pklopping/heimdall/hardware/outside_boards/Reference/readme.md

# Reference Docs

## Antenna Design

The [NXP Antenna Tool](https://community.nxp.com/t5/NFC/bd-p/nfc) was used to
identify the component values and antenna circuit design.
