pklopping/heimdall/hardware/shared/cots/VLS6045EX-3R3N.stp

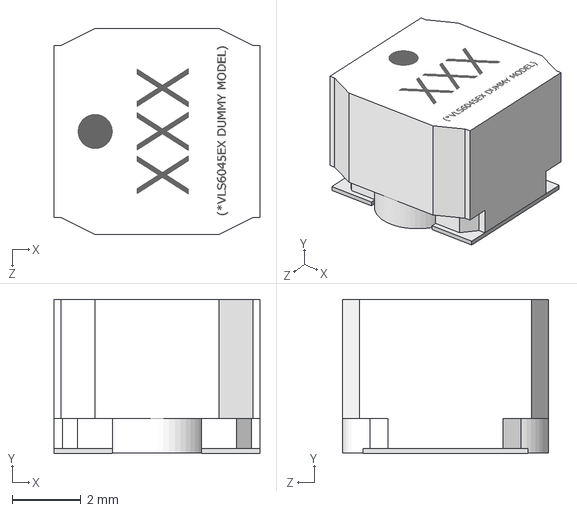
[picture p1: CAD file, 2026-01-07]
hardware/shared/cots/VLS6045EX-3R3N.stp
6.00 x 4.50 x 6.00 mm
VLS6045EX_C(3Dmodel)
VLS6045EX_T(3Dmodel)
