pklopping/heimdall/hardware/shared/cots/5-2337993-2.stp

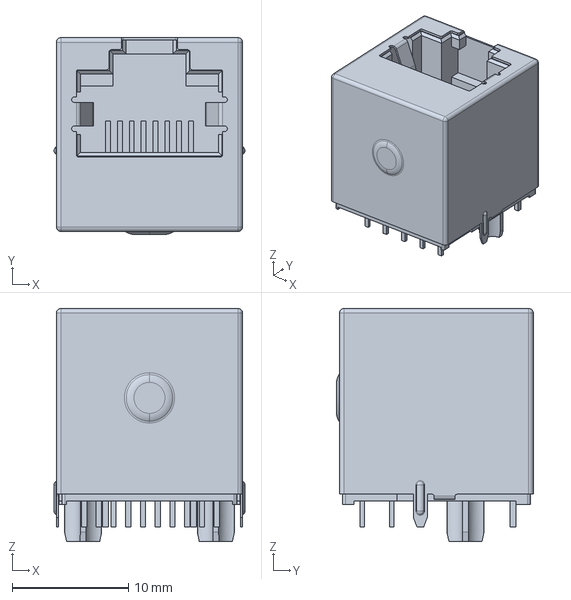
[picture p2: CAD file, 2025-12-01]
hardware/shared/cots/5-2337993-2.stp
16.4 x 16.9 x 20.1 mm
