pklopping/heimdall/hardware/shared/cots/10118193-0001lfc.stp

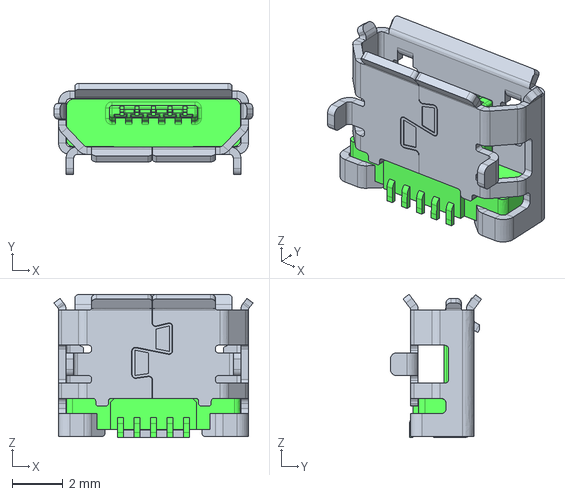
[picture p3: CAD file, 2025-12-01]
hardware/shared/cots/10118193-0001lfc.stp
7.86 x 3.60 x 5.66 mm
