pklopping/heimdall/hardware/shared/cots/CMT-1075-SMT-TR.stp

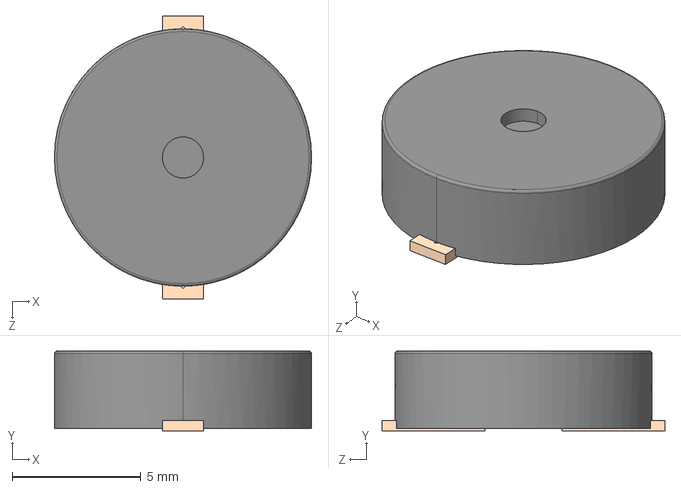
[picture p4: CAD file, 2025-09-20]
hardware/shared/cots/CMT-1075-SMT-TR.stp
10.0 x 3.10 x 11.0 mm
