pklopping/heimdall/hardware/shared/cots/43045-1019.stp

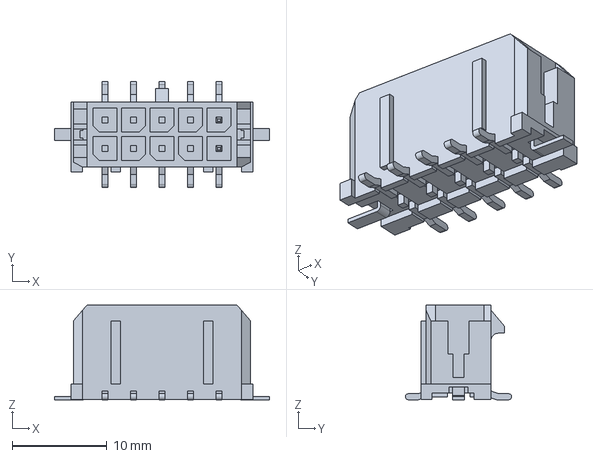
[picture p5: CAD file, 2025-09-20]
hardware/shared/cots/43045-1019.stp
22.6 x 11.2 x 9.96 mm
