pklopping/heimdall/hardware/shared/cots/CLRC66303HNY.stp

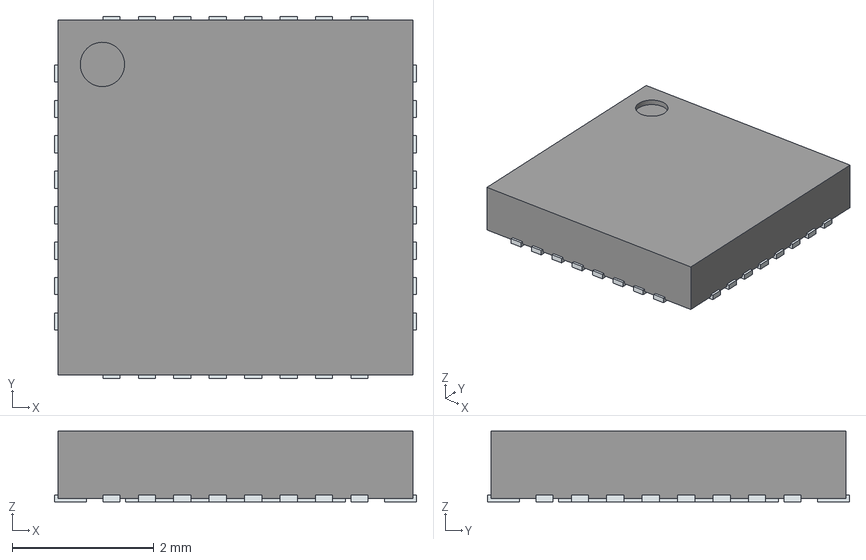
[picture p6: CAD file, 2025-09-20]
hardware/shared/cots/CLRC66303HNY.stp
5.10 x 5.10 x 1.00 mm
ThermalPin
PinsArrayLR
PinsArrayTB
