pklopping/heimdall/hardware/shared/cots/53398-1071.stp

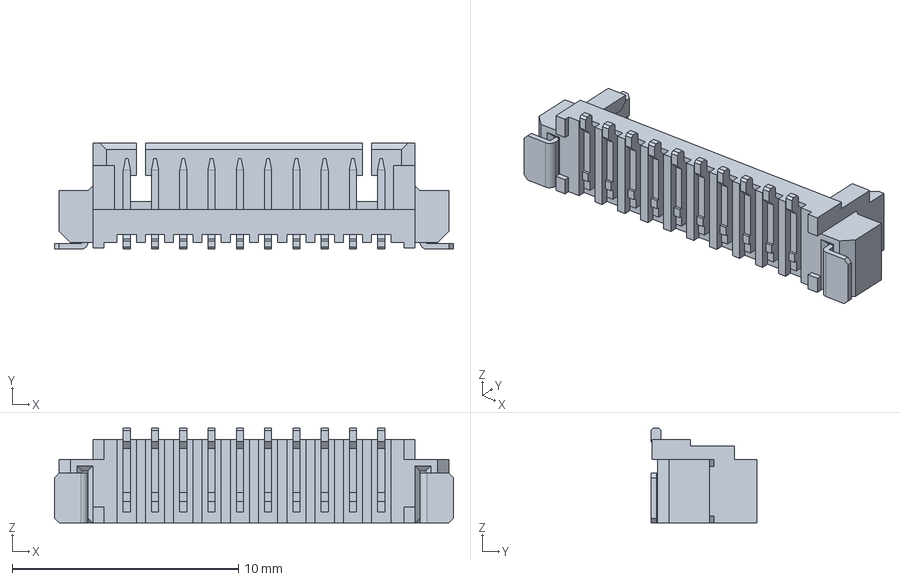
[picture p7: CAD file, 2025-09-20]
hardware/shared/cots/53398-1071.stp
17.6 x 4.70 x 4.20 mm
