pklopping/heimdall/hardware/buzzer_test/buzzer_test.kicad_pcb

## KiCad design hardware/buzzer_test/buzzer_test.kicad_pcb (2026-04-17)

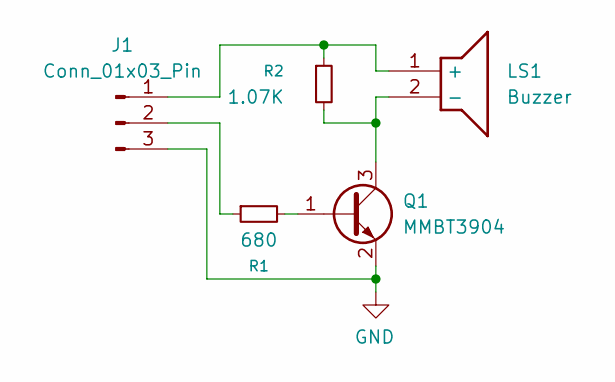
[picture p8: schematic buzzer_test.kicad_sch]

Parts:
J1: Conn_01x03_Pin; PinHeader_1x03_P2.54mm_Vertical
LS1: Buzzer; CMT1075SMTTR; Mouser Part Number 490-CMT-1075-SMT-TR
Q1: MMBT3904; SOT-23
R1: 680; R_0805_2012Metric
R2: 1.07K; R_0805_2012Metric

Connections:
GND: J1.3, Q1.2 (E)
unnamed: J1.1, LS1.1 (+), R2.1
unnamed: J1.2, R1.1
unnamed: LS1.2 (-), Q1.3 (C), R2.2
unnamed: Q1.1 (B), R1.2

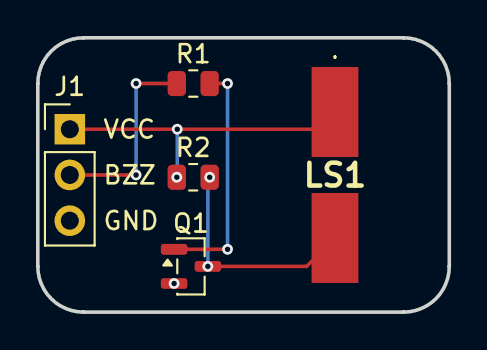
[picture p9: board buzzer_test.kicad_pcb from above]

Board: 2 copper layers, 22.9 x 15.2 mm, 5 parts (0 on the bottom side), 5 nets.
