pklopping/heimdall/hardware/inside_board/heimdall_insideboard.kicad_pcb

## KiCad design hardware/inside_board/heimdall_insideboard.kicad_pcb (2026-04-14)

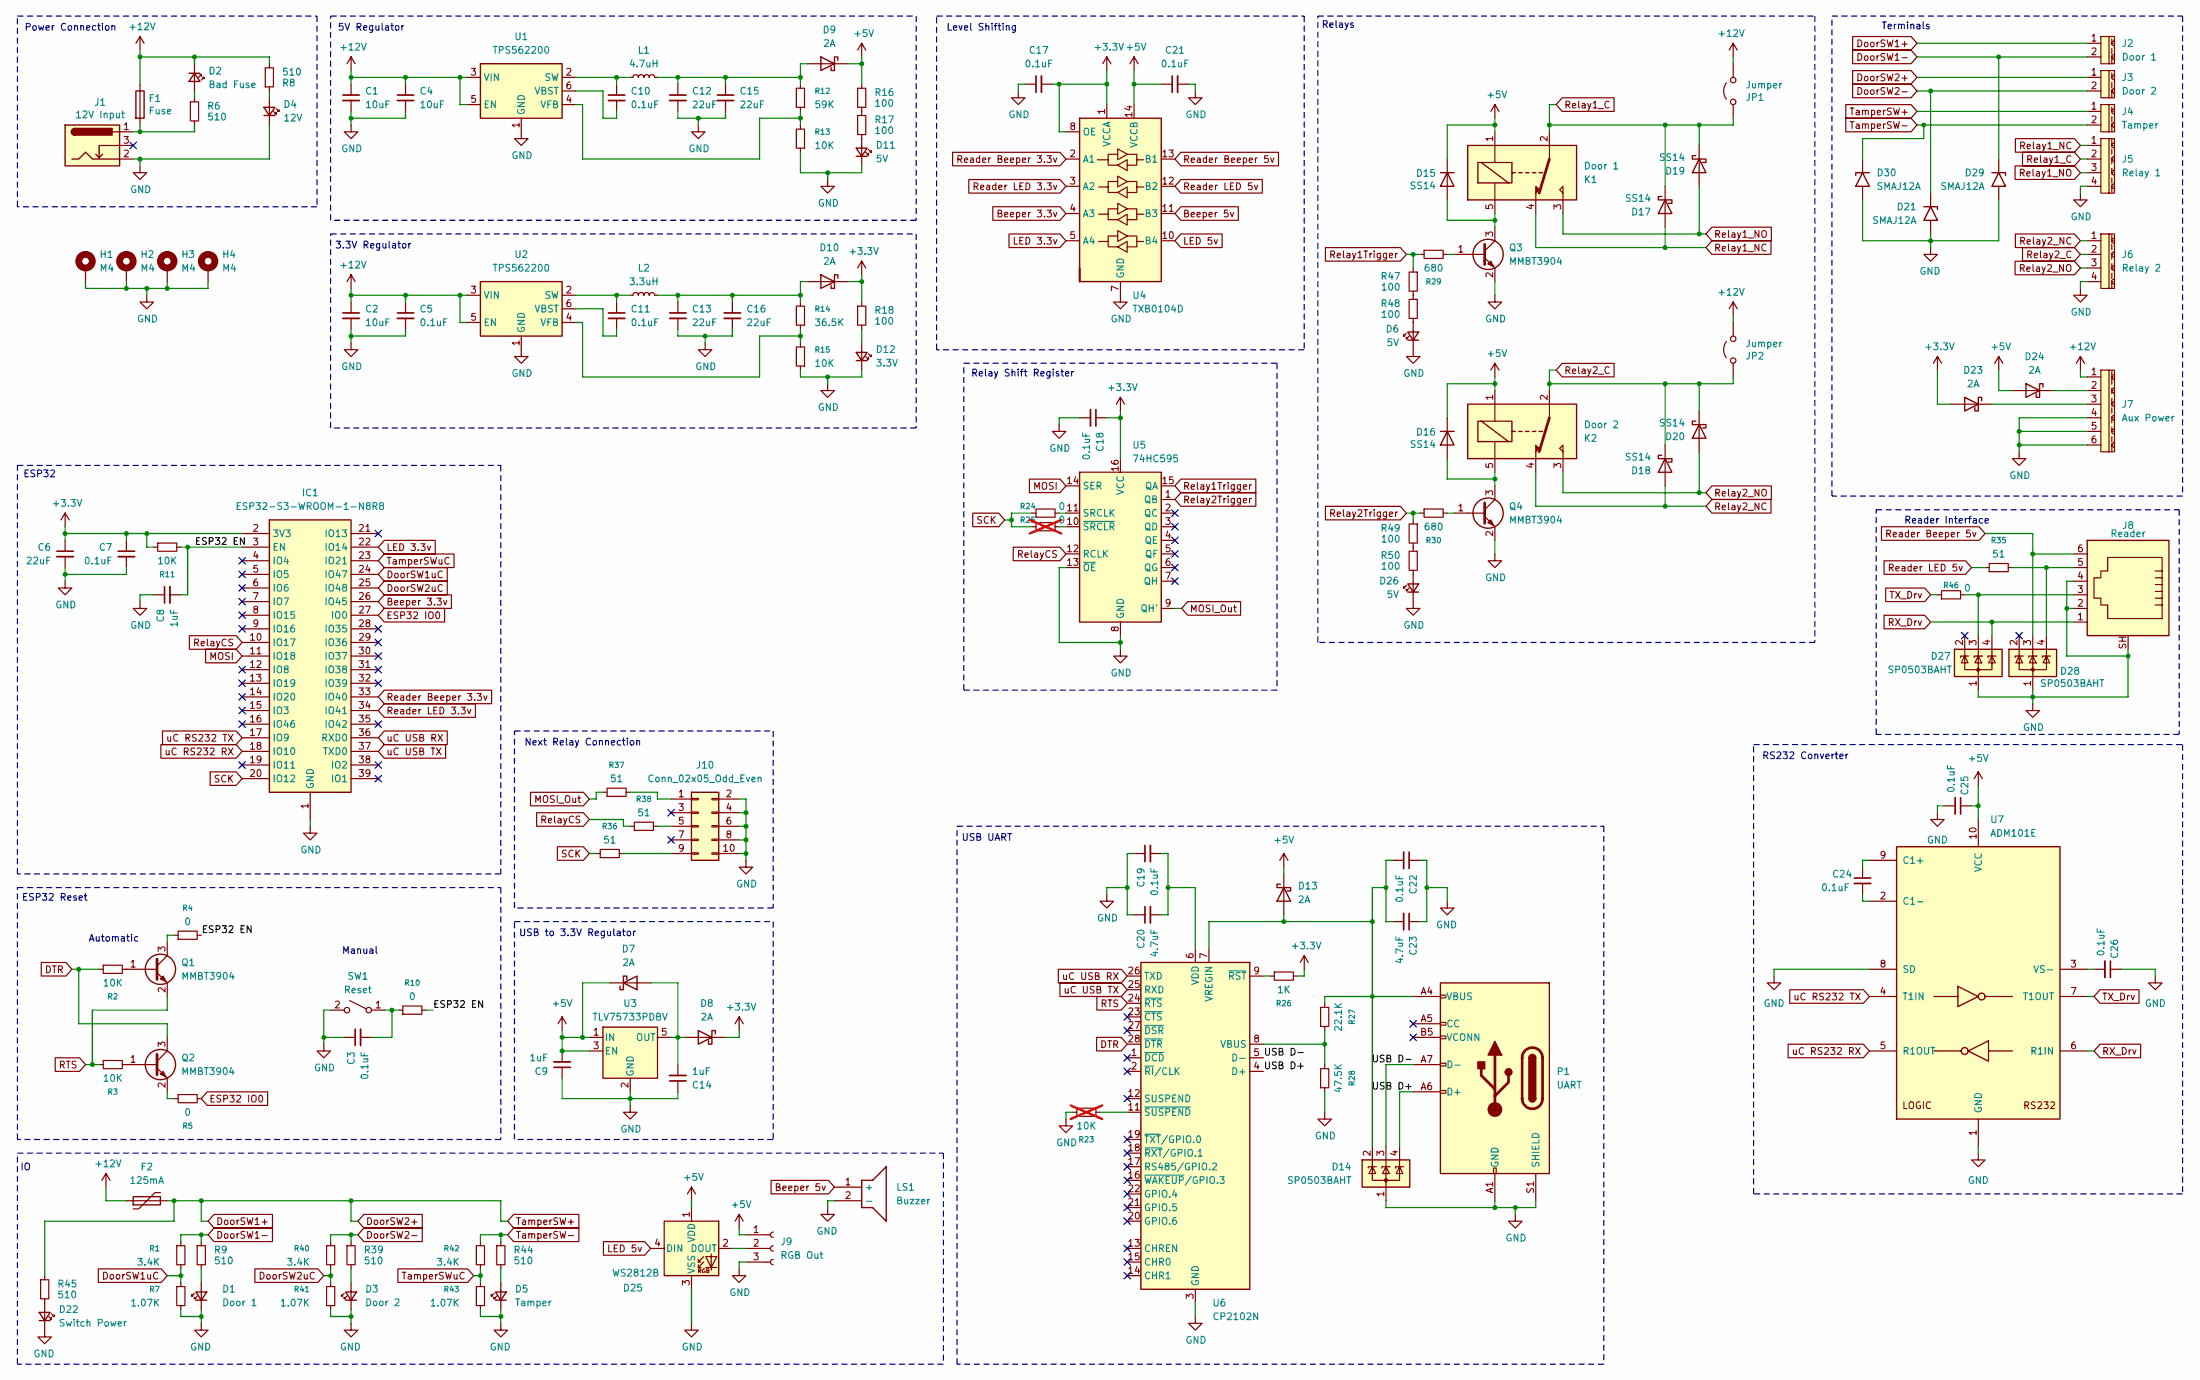
[picture p10: schematic heimdall_insideboard.kicad_sch, Heimdall Relay Board]

Parts:
C1, C2, C4: 10uF; C_0805_2012Metric
C3, C5, C7, C10, C11, C17, C18, C19, C21, C22, C24, C25, C26: 0.1uF; C_0805_2012Metric
C6, C12, C13, C15, C16: 22uF; C_0805_2012Metric
C8, C9, C14: 1uF; C_0805_2012Metric
C20, C23: 4.7uF; C_0805_2012Metric
D1: Door 1; LED_0805_2012Metric
D2: Bad Fuse; LED_0805_2012Metric
D3: Door 2; LED_0805_2012Metric
D4: 12V; LED_0805_2012Metric
D5: Tamper; LED_0805_2012Metric
D6, D11, D26: 5V; LED_0805_2012Metric
D7, D8, D9, D10, D13, D23, D24: 2A; D_SMB
D12: 3.3V; LED_0805_2012Metric
D14, D27, D28: SP0503BAHT; SOT-143
D15, D16, D17, D18, D19, D20: SS14; D_SMA
D21, D29, D30: SMAJ12A; D_SMA
D22: Switch Power; LED_0805_2012Metric
D25: WS2812B; LED_WS2812B_PLCC4_5.0x5.0mm_P3.2mm
F1: Fuse; Fuseholder_Clip-5x20mm_Littelfuse_521_Lateral_P17.00x5.00mm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
F2: 125mA; Fuse_1206_3216Metric
H1, H2, H3, H4: M4; MountingHole_4.3mm_M4_Pad_Via
IC1: ESP32-S3-WROOM-1-N8R8; ESP32S3WROOM1N8R8; Mouser Part Number 356-EP32S3WROOM1N8R8
J1: 12V Input; BarrelJack_Wuerth_6941xx301002
J2: Door 1; 1759017
J3: Door 2; 1759017
J4: Tamper; 1759017
J5: Relay 1; 1759033
J6: Relay 2; 1759033
J7: Aux Power; 1759059
J8: Reader; CRJ0241TH
J9: RGB Out; PinHeader_1x03_P2.54mm_Vertical
J10: Conn_02x05_Odd_Even; 75869-101LF
JP1, JP2: Jumper; PinHeader_1x03_P2.54mm_Vertical
K1: Door 1; G6RN17EASICFHADC5; Manufacturer_Part_Number G6RN-17-E-ASI-CF-HA DC5
K2: Door 2; G6RN17EASICFHADC5; Manufacturer_Part_Number G6RN-17-E-ASI-CF-HA DC5
L1: 4.7uH; SRR1260A4R7Y
L2: 3.3uH; SRR1260A4R7Y
LS1: Buzzer; CMT1075SMTTR; Mouser Part Number 490-CMT-1075-SMT-TR
P1: UART; USB4920-00-A
Q1, Q2, Q3, Q4: MMBT3904; SOT-23
R1, R40, R42: 3.4K; R_0805_2012Metric
R2, R3, R11, R13, R15: 10K; R_0805_2012Metric
R4, R5, R10, R24, R46: 0; R_0805_2012Metric
R6, R8, R9, R39, R44, R45: 510; R_0805_2012Metric
R7, R41, R43: 1.07K; R_0805_2012Metric
R12: 59K; R_0805_2012Metric
R14: 36.5K; R_0805_2012Metric
R16, R17, R18, R47, R48, R49, R50: 100; R_0805_2012Metric
R23: 10K; R_0805_2012Metric; not fitted
R25: 0; R_0805_2012Metric; not fitted
R26: 1K; R_0805_2012Metric
R27: 22.1K; R_0805_2012Metric
R28: 47.5K; R_0805_2012Metric
R29, R30: 680; R_0805_2012Metric
R35, R36, R37, R38: 51; R_0805_2012Metric
SW1: Reset; SW_SPST_Omron_B3FS-100xP
U1, U2: TPS562200; SOT-23-6
U3: TLV75733PDBV; SOT-23-5
U4: TXB0104D; SOIC-14_3.9x8.7mm_P1.27mm
U5: 74HC595; SOIC-16W_7.5x10.3mm_P1.27mm
U6: CP2102N; QFN-28-1EP_5x5mm_P0.5mm_EP3.35x3.35mm
U7: ADM101E; MSOP-10_3x3mm_P0.5mm

Connections:
+3.3V: C6.1, C7.1, C17.2, C18.1, D8.1 (K), D10.1 (K), D23.2 (A), IC1.2 (3V3), R11.1, R18.1, R26.2, U4.1 (VCCA), U4.8 (OE), U5.16 (VCC)
+5V: C9.2, C21.1, C25.1, D7.1 (K), D9.1 (K), D13.1 (K), D15.1 (K), D16.1 (K), D24.2 (A), D25.1 (VDD), J9.1, K1.1, K2.1, R16.1, U3.1 (IN), U3.3 (EN), U4.14 (VCCB), U7.10 (VCC)
+12V: C1.1, C2.1, C4.1, C5.1, D2.1 (K), F1.1, F2.1, J7.1, JP1.1 (A), JP2.1 (A), R8.2, U1.3 (VIN), U1.5 (EN), U2.3 (VIN), U2.5 (EN)
/ESP32 EN: C8.2, IC1.3 (EN), R4.2, R10.2, R11.2
/USB D+: D14.4 (K), P1.A6 (D+), U6.4 (D+)
/USB D-: D14.3 (K), P1.A7 (D-), U6.5 (D-)
Beeper 3.3v: IC1.26 (IO45), U4.4 (A3)
Beeper 5v: LS1.1 (+), U4.11 (B3)
DTR: Q2.3 (C), R2.1, U6.28 (~DTR)
DoorSW1+: F2.2, J2.1, J3.1, J4.1, R45.1
DoorSW1-: D29.1 (A1), J2.2, R1.1, R9.1
DoorSW1uC: IC1.24 (IO47), R1.2, R7.1
DoorSW2-: D21.1 (A1), J3.2, R39.1, R40.1
DoorSW2uC: IC1.25 (IO48), R40.2, R41.1
ESP32 IO0: IC1.27 (IO0), R5.2
GND: C1.2, C2.2, C3.1, C4.2, C5.2, C6.2, C7.2, C8.1, C9.1, C12.2, C13.2, C14.1, C15.2, C16.2, C17.1, C18.2, C19.1, C20.1, C21.2, C22.1, C23.1, C25.2, C26.1, D1.1 (K), D3.1 (K), D4.1 (K), D5.1 (K), D6.1 (K), D11.1 (K), D12.1 (K), D14.1 (A), D21.2 (A2), D22.1 (K), D25.3 (VSS), D26.1 (K), D27.1 (A), D28.1 (A), D29.2 (A2), D30.2 (A2), H1.1, H2.1, H3.1, H4.1, IC1.1 (GND), J1.2, J5.4, J6.4, J7.4, J7.5, J7.6, J8.2, J8.4, J8.SH, J9.3, J10.2, J10.4, J10.6, J10.8, J10.10, LS1.2 (-), P1.A1 (GND), P1.A12 (GND), P1.B1 (GND), P1.B12 (GND), P1.S1 (SHIELD), Q3.2 (E), Q4.2 (E), R7.2, R13.1, R15.1, R23.1, R28.1, R41.2, R43.2, SW1.2 (B), U1.1 (GND), U2.1 (GND), U3.2 (GND), U4.7 (GND), U5.8 (GND), U5.13 (~OE), U6.3 (GND), U6.29 (GND), U7.1 (GND), U7.8 (SD)
LED 3.3v: IC1.22 (IO14), U4.5 (A4)
LED 5v: D25.4 (DIN), U4.10 (B4)
MOSI: IC1.11 (IO18), U5.14 (SER)
MOSI_Out: R37.1, U5.9 (QH')
unnamed: D1.2 (A), R9.2
unnamed: D2.2 (A), R6.1
unnamed: D3.2 (A), R39.2
unnamed: D4.2 (A), R8.1
unnamed: D5.2 (A), R44.2
unnamed: D6.2 (A), R48.2
unnamed: C14.2, D7.2 (A), D8.2 (A), U3.5 (OUT)
unnamed: C12.1, C15.1, D9.2 (A), L1.2, R12.2
unnamed: C13.1, C16.1, D10.2 (A), L2.2, R14.2
unnamed: D11.2 (A), R17.2
unnamed: D12.2 (A), R18.2
unnamed: C22.2, C23.2, D13.2 (A), D14.2 (K), P1.A4 (VBUS), P1.A9 (VBUS), P1.B4 (VBUS), P1.B9 (VBUS), R27.2, U6.7 (VREGIN)
unnamed: D15.2 (A), K1.5, Q3.3 (C)
unnamed: D16.2 (A), K2.5, Q4.3 (C)
unnamed: D22.2 (A), R45.2
unnamed: D23.1 (K), J7.3
unnamed: D24.1 (K), J7.2
unnamed: D25.2 (DOUT), J9.2
unnamed: D26.2 (A), R50.2
unnamed: D27.3 (K), J8.3, R46.2
unnamed: D28.4 (K), J8.5, R35.2
unnamed: F1.2, J1.1, R6.2
unnamed: J10.1, R37.2
unnamed: J10.5, R38.2
unnamed: J10.9, R36.2
unnamed: Q1.1 (B), R2.2
unnamed: Q1.3 (C), R4.1
unnamed: Q2.1 (B), R3.2
unnamed: Q2.2 (E), R5.1
unnamed: Q3.1 (B), R29.2
unnamed: Q4.1 (B), R30.2
unnamed: R16.2, R17.1
unnamed: R47.2, R48.1
unnamed: R49.2, R50.1
unnamed: C3.2, R10.1, SW1.1 (A)
unnamed: C10.1, L1.1, U1.2 (SW)
unnamed: C10.2, U1.6 (VBST)
unnamed: R12.1, R13.2, U1.4 (VFB)
unnamed: C11.1, L2.1, U2.2 (SW)
unnamed: C11.2, U2.6 (VBST)
unnamed: R14.1, R15.2, U2.4 (VFB)
unnamed: R24.2, U5.11 (SRCLK)
unnamed: R25.2, U5.10 (~SRCLR)
unnamed: R27.1, R28.2, U6.8 (VBUS)
unnamed: C19.2, C20.2, U6.6 (VDD)
unnamed: R26.1, U6.9 (~RST)
unnamed: R23.2, U6.11 (~SUSPEND)
unnamed: C24.1, U7.9 (C1+)
unnamed: C24.2, U7.2 (C1-)
unnamed: C26.2, U7.3 (VS-)
RTS: Q1.2 (E), R3.1, U6.24 (~RTS)
RX_Drv: D27.4 (K), J8.1, U7.6 (R1IN)
Reader Beeper 3.3v: IC1.33 (IO40), U4.2 (A1)
Reader Beeper 5v: D28.3 (K), J8.6, U4.13 (B1)
Reader LED 3.3v: IC1.34 (IO41), U4.3 (A2)
Reader LED 5v: R35.1, U4.12 (B2)
Relay1Trigger: R29.1, R47.1, U5.15 (QA)
Relay1_C: D17.1 (K), D19.1 (K), J5.2, JP1.2 (B), K1.2
Relay1_NC: D17.2 (A), J5.1, K1.4
Relay1_NO: D19.2 (A), J5.3, K1.3
Relay2Trigger: R30.1, R49.1, U5.1 (QB)
Relay2_C: D18.1 (K), D20.1 (K), J6.2, JP2.2 (B), K2.2
Relay2_NC: D18.2 (A), J6.1, K2.4
Relay2_NO: D20.2 (A), J6.3, K2.3
RelayCS: IC1.10 (IO17), R38.1, U5.12 (RCLK)
SCK: IC1.20 (IO12), R24.1, R25.1, R36.1
TX_Drv: R46.1, U7.7 (T1OUT)
TamperSW-: D30.1 (A1), J4.2, R42.1, R44.1
TamperSWuC: IC1.23 (IO21), R42.2, R43.1
uC RS232 RX: IC1.18 (IO10), U7.5 (R1OUT)
uC RS232 TX: IC1.17 (IO9), U7.4 (T1IN)
uC USB RX: IC1.36 (RXD0), U6.26 (TXD)
uC USB TX: IC1.37 (TXD0), U6.25 (RXD)

Notes on the sheet:
Power Connection
Relay Shift Register
Automatic
RS232 Converter
ESP32 Reset
USB to 3.3V Regulator
Terminals
Next Relay Connection
Manual
3.3V Regulator
5V Regulator
Reader Interface
Relays
Level Shifting
USB UART
ESP32

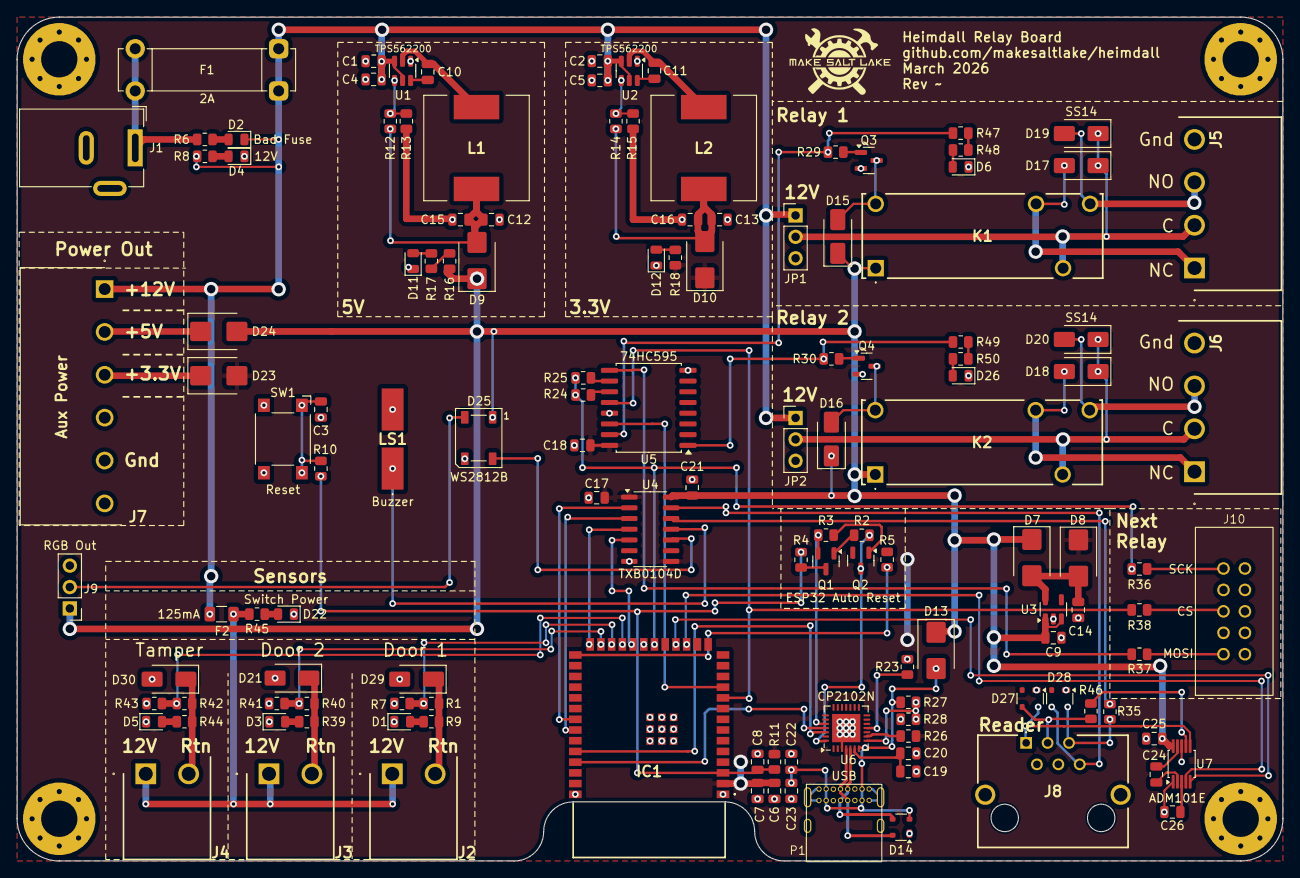
[picture p11: board heimdall_insideboard.kicad_pcb from above]

Board: 2 copper layers, 150.0 x 100.0 mm, 135 parts (0 on the bottom side), 93 nets.
