pklopping/heimdall/hardware/outside_boards/reader/reader.kicad_pcb

## KiCad design hardware/outside_boards/reader/reader.kicad_pcb (2026-01-20)

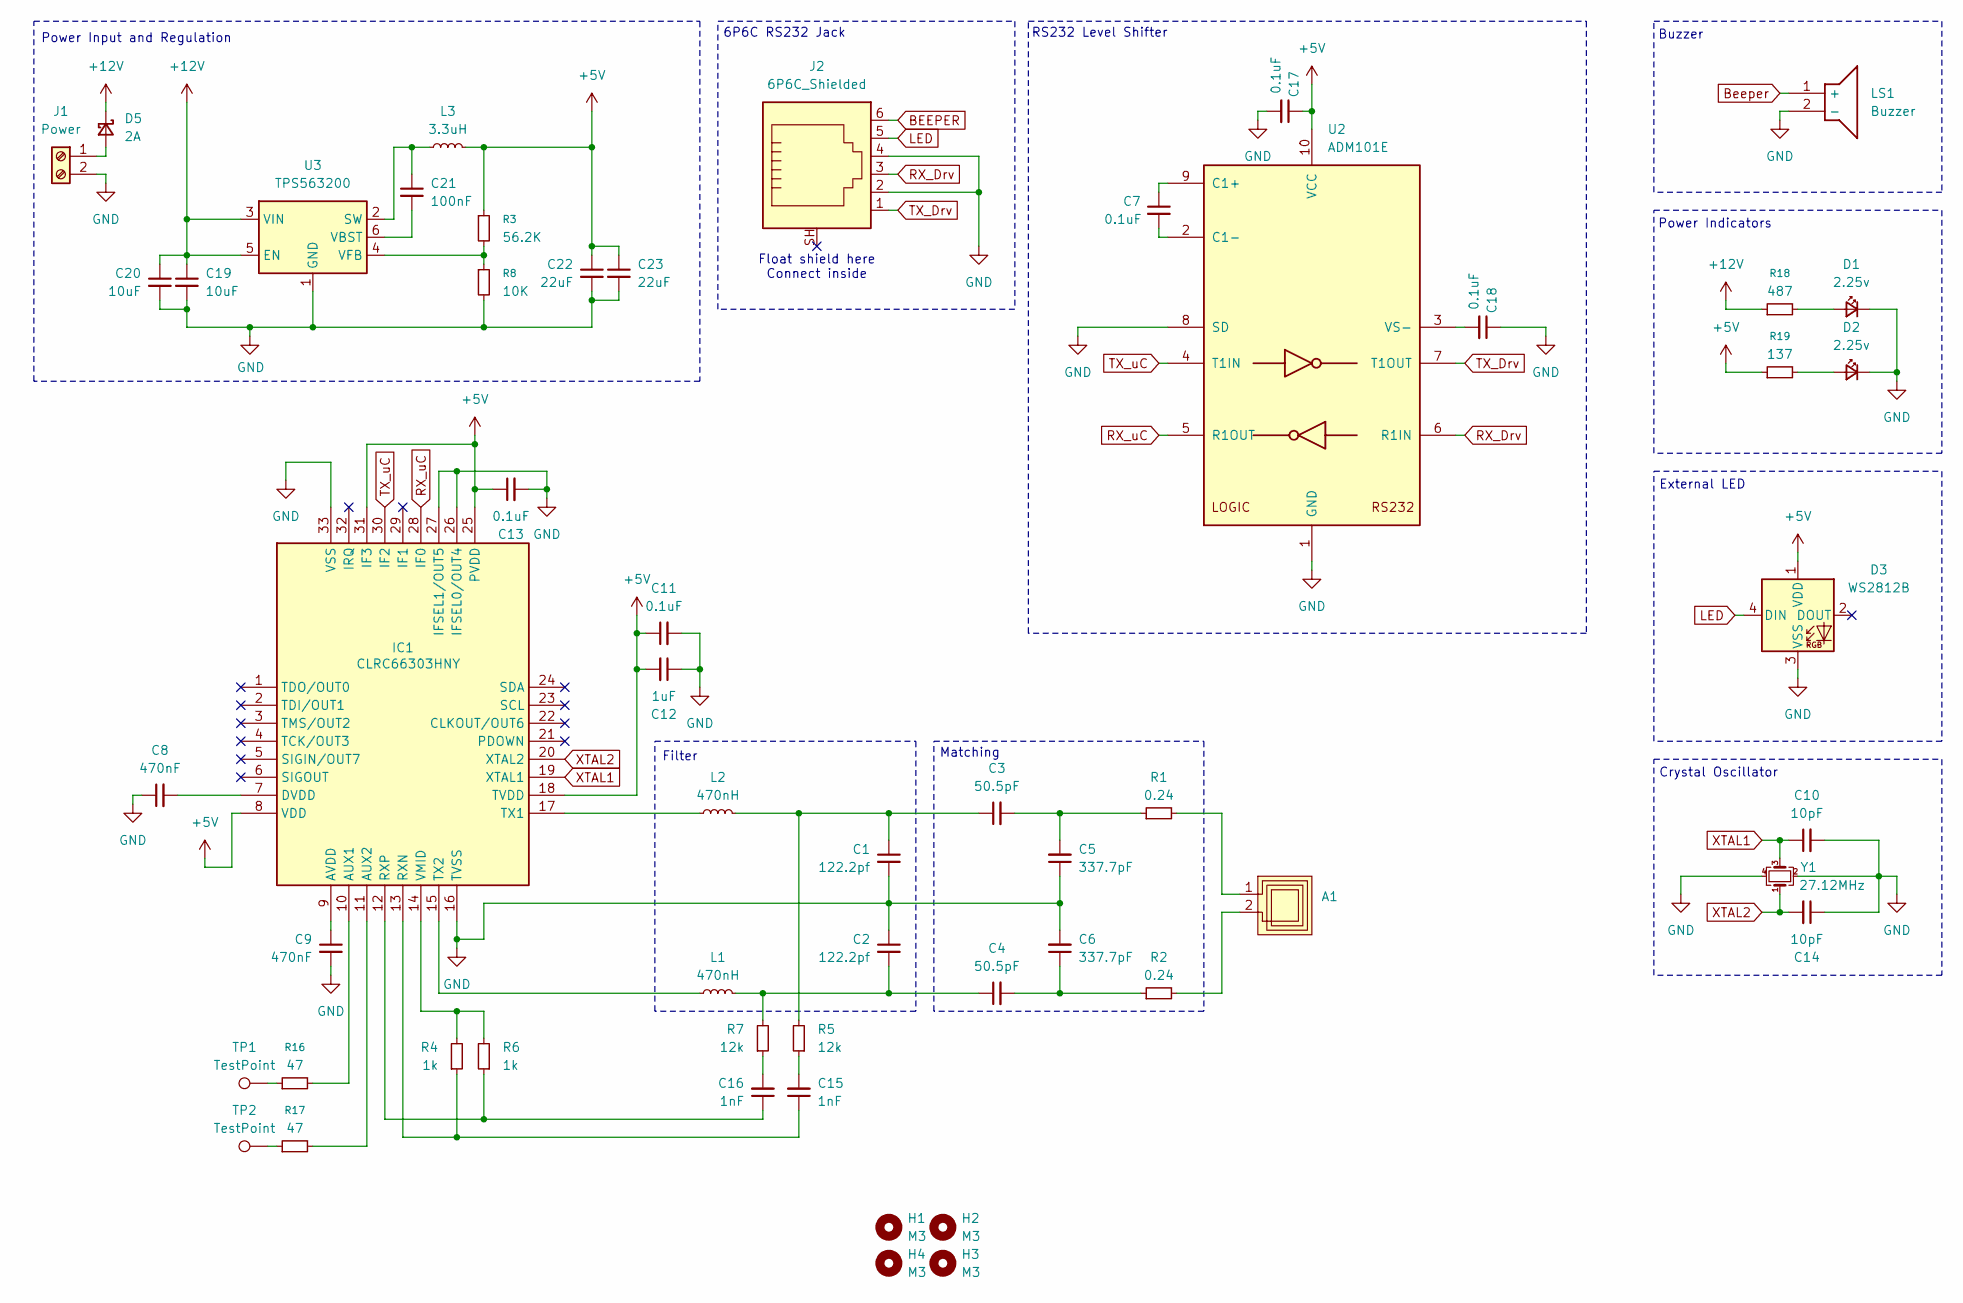
[picture p12: schematic reader.kicad_sch, Heimdall Reader]

Parts:
A1: Anetnna_50x50
C1, C2: 122.2pf; C_0805_2012Metric
C3, C4: 50.5pF; C_0805_2012Metric
C5, C6: 337.7pF; C_0805_2012Metric
C7, C11, C13, C17, C18: 0.1uF; C_0805_2012Metric
C8, C9: 470nF; C_0805_2012Metric
C10, C14: 10pF; C_0805_2012Metric
C12: 1uF; C_0805_2012Metric
C15, C16: 1nF; C_0805_2012Metric
C19, C20: 10uF; C_0805_2012Metric
C21: 100nF; C_0805_2012Metric
C22, C23: 22uF; C_0805_2012Metric
D1, D2: 2.25v; LED_0805_2012Metric
D3: WS2812B; LED_WS2812B_PLCC4_5.0x5.0mm_P3.2mm
D5: 2A; D_1206_3216Metric
H1, H2, H3, H4: M3; MountingHole_3.2mm_M3
IC1: CLRC66303HNY; QFN50P500X500X100-33N; Mouser Part Number 771-CLRC66303HNY
J1: Power; 1991095
J2: 6P6C_Shielded; CRJ0241TH
L1, L2: 470nH; L_0805_2012Metric
L3: 3.3uH; L_TDK_VLS6045EX_VLS6045AF
LS1: Buzzer; CMT1075SMTTR; Mouser Part Number 490-CMT-1075-SMT-TR
R1, R2: 0.24; R_0805_2012Metric
R3: 56.2K; R_0805_2012Metric
R4, R6: 1k; R_0805_2012Metric
R5, R7: 12k; R_0805_2012Metric
R8: 10K; R_0805_2012Metric
R16, R17: 47; R_0805_2012Metric
R18: 487; R_0805_2012Metric
R19: 137; R_0805_2012Metric
TP1, TP2: TestPoint; TestPoint_Pad_D1.5mm
U2: ADM101E; MSOP-10_3x3mm_P0.5mm
U3: TPS563200; SOT-23-6
Y1: 27.12MHz; Crystal_SMD_3225-4Pin_3.2x2.5mm

Connections:
+5V: C11.1, C12.2, C13.1, C17.1, C22.1, C23.1, D3.1 (VDD), IC1.8 (VDD), IC1.18 (TVDD), IC1.25 (PVDD), IC1.31 (IF3), L3.2, R3.1, R19.1, U2.10 (VCC)
+12V: C19.1, C20.1, D5.1 (K), R18.1, U3.3 (VIN), U3.5 (EN)
BEEPER: J2.6
Beeper: LS1.1 (+)
GND: C1.2, C2.1, C5.1, C6.2, C8.1, C9.2, C10.2, C11.2, C12.1, C13.2, C14.1, C17.2, C18.1, C19.2, C20.2, C22.2, C23.2, D1.1 (K), D2.1 (K), D3.3 (VSS), IC1.16 (TVSS), IC1.26 (IFSEL0/OUT4), IC1.27 (IFSEL1/OUT5), IC1.33 (VSS), J1.2, J2.2, J2.4, LS1.2 (-), R8.2, U2.1 (GND), U2.8 (SD), U3.1 (GND), Y1.2, Y1.4
LED: D3.4 (DIN), J2.5
unnamed: A1.1, R1.2
unnamed: A1.2, R2.2
unnamed: C1.1, C3.1, L2.2, R5.2
unnamed: C2.2, C4.1, L1.2, R7.2
unnamed: C3.2, C5.2, R1.1
unnamed: C4.2, C6.1, R2.1
unnamed: C15.2, R5.1
unnamed: C16.2, R7.1
unnamed: D1.2 (A), R18.2
unnamed: D2.2 (A), R19.2
unnamed: D5.2 (A), J1.1
unnamed: IC1.10 (AUX1), R16.2
unnamed: IC1.11 (AUX2), R17.2
unnamed: C9.1, IC1.9 (AVDD)
unnamed: C8.2, IC1.7 (DVDD)
unnamed: C15.1, IC1.13 (RXN), R4.1
unnamed: C16.1, IC1.12 (RXP), R6.1
unnamed: IC1.17 (TX1), L2.1
unnamed: IC1.15 (TX2), L1.1
unnamed: IC1.14 (VMID), R4.2, R6.2
unnamed: R16.1, TP1.1
unnamed: R17.1, TP2.1
unnamed: C7.1, U2.9 (C1+)
unnamed: C7.2, U2.2 (C1-)
unnamed: C18.2, U2.3 (VS-)
unnamed: C21.1, L3.1, U3.2 (SW)
unnamed: C21.2, U3.6 (VBST)
unnamed: R3.2, R8.1, U3.4 (VFB)
RX_Drv: J2.3, U2.6 (R1IN)
RX_uC: IC1.28 (IF0), U2.5 (R1OUT)
TX_Drv: J2.1, U2.7 (T1OUT)
TX_uC: IC1.30 (IF2), U2.4 (T1IN)
XTAL1: C10.1, IC1.19 (XTAL1), Y1.3
XTAL2: C14.2, IC1.20 (XTAL2), Y1.1

Notes on the sheet:
External LED
Crystal Oscillator
Power Indicators
Matching
Float shield here Connect inside
Buzzer
6P6C RS232 Jack
Power Input and Regulation
RS232 Level Shifter
Filter

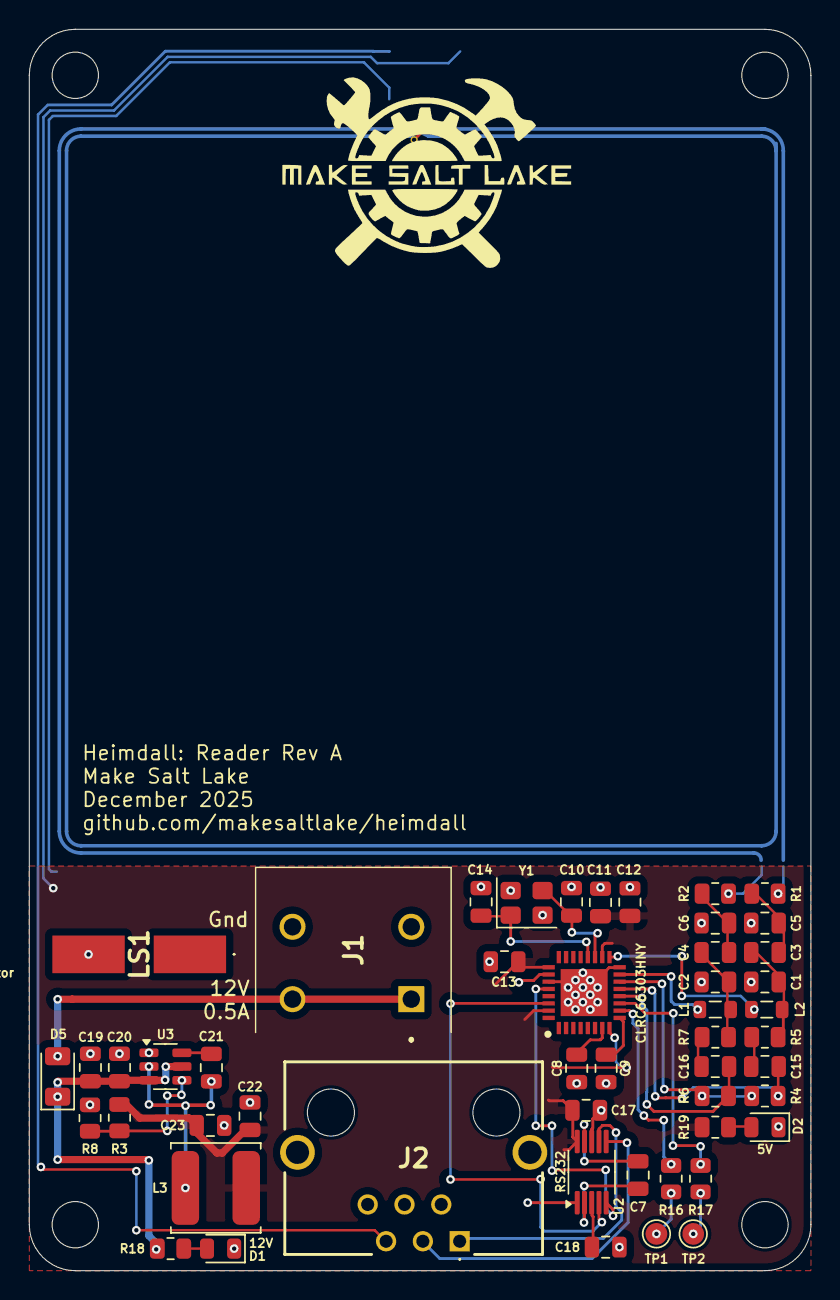
[picture p13: board reader.kicad_pcb from above]

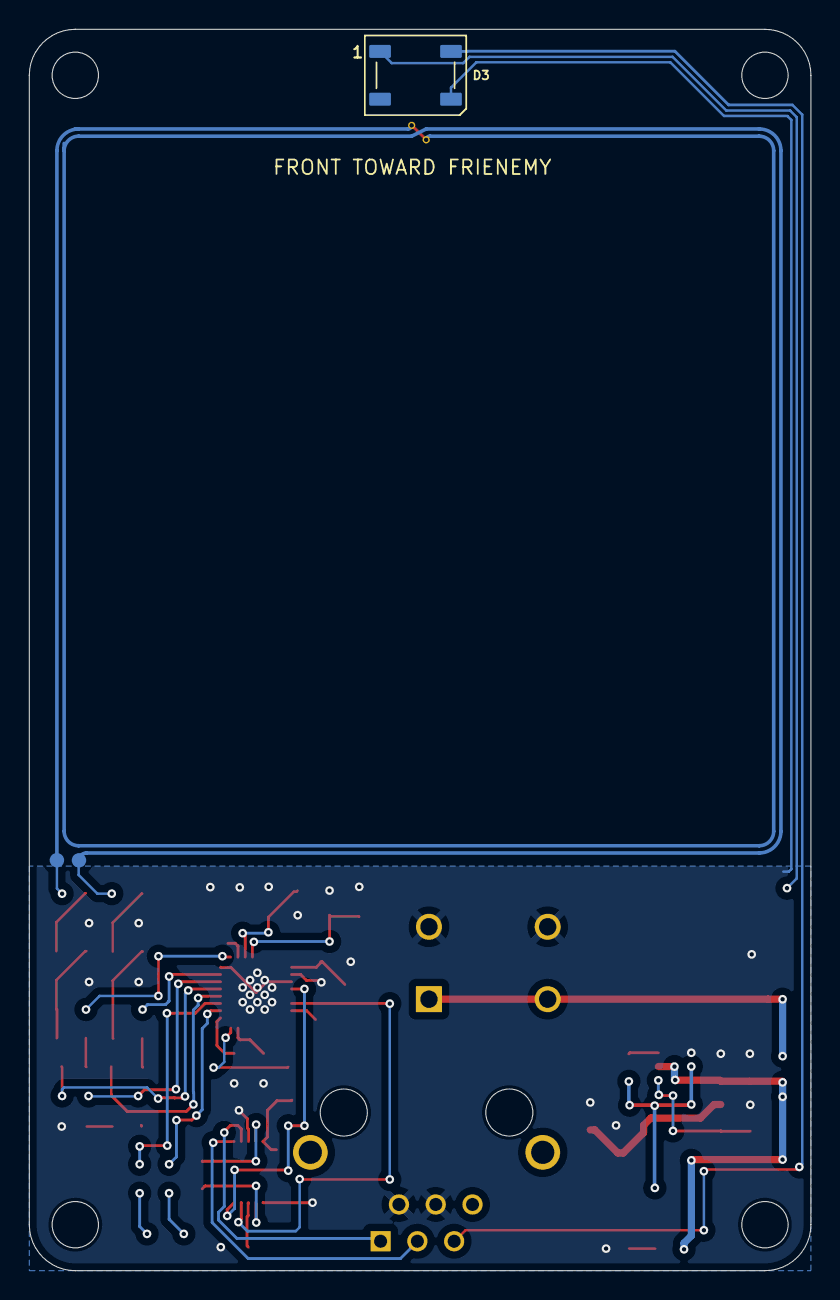
[picture p14: board reader.kicad_pcb from below]

Board: 2 copper layers, 54.0 x 85.7 mm, 56 parts (2 on the bottom side), 38 nets.
