pklopping/heimdall/hardware/picoblade_adaptor/picoblade_adaptor.kicad_pcb

## KiCad design hardware/picoblade_adaptor/picoblade_adaptor.kicad_pcb (2025-10-17)

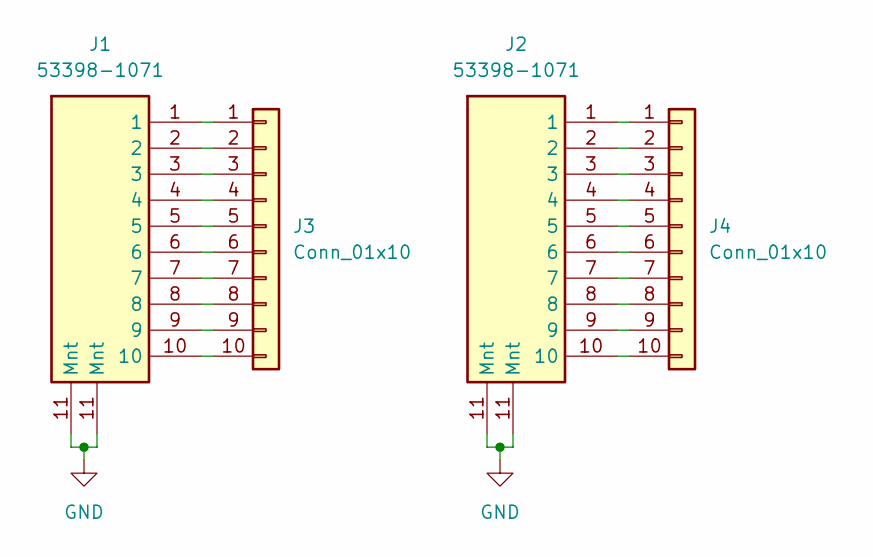
[picture p15: schematic picoblade_adaptor.kicad_sch]

Parts:
J1, J2: 53398-1071; 533981071; Mouser Part Number 538-53398-1071
J3, J4: Conn_01x10; PinHeader_1x10_P2.54mm_Vertical

Connections:
GND: J1.11 (Mnt), J2.11 (Mnt)
unnamed: J1.1, J3.1
unnamed: J1.2, J3.2
unnamed: J1.3, J3.3
unnamed: J1.4, J3.4
unnamed: J1.5, J3.5
unnamed: J1.6, J3.6
unnamed: J1.7, J3.7
unnamed: J1.8, J3.8
unnamed: J1.9, J3.9
unnamed: J1.10, J3.10
unnamed: J2.1, J4.1
unnamed: J2.2, J4.2
unnamed: J2.3, J4.3
unnamed: J2.4, J4.4
unnamed: J2.5, J4.5
unnamed: J2.6, J4.6
unnamed: J2.7, J4.7
unnamed: J2.8, J4.8
unnamed: J2.9, J4.9
unnamed: J2.10, J4.10

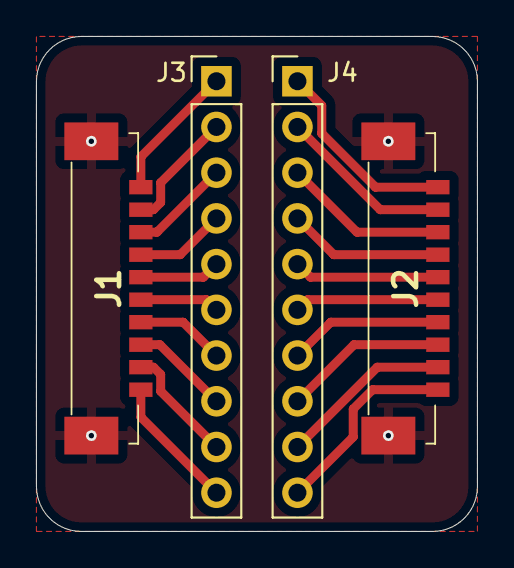
[picture p16: board picoblade_adaptor.kicad_pcb from above]

Board: 2 copper layers, 24.5 x 27.5 mm, 4 parts (0 on the bottom side), 21 nets.
