pklopping/heimdall/(commit log)

2025-09-20 Created RFID board, performed KiCAD organization/cleanup
    [43045-1019.stp, 53398-1071.stp, CLRC66303HNY.stp, CMT-1075-SMT-TR.stp, heimdall_insideboard.kicad_pcb, heimdall_insideboard.kicad_sch, heimdall_insideboard.sch, reader.kicad_pcb]
2025-10-17 Pico-blade adaptor pcb test
    [picoblade_adaptor.kicad_pcb, picoblade_adaptor.kicad_sch]
2025-10-17 Adding silkscreen to the adaptor
    [picoblade_adaptor.kicad_pcb]
2025-12-01 Halfway through the conversion, prolly
    [10118193-0001lfc.stp, 5-2337993-2.stp, reader.kicad_pcb, reader.kicad_sch]
2025-12-01 More layout and datasheets
    [reader.kicad_pcb, reader.kicad_sch]
2025-12-03 Playing with the layout and fixing footprints
    [reader.kicad_pcb, reader.kicad_sch]
2025-12-03 This layout is insane
    [reader.kicad_pcb, reader.kicad_sch]
2025-12-04 PCB layout
    [reader.kicad_pcb]
2026-01-07 Updated schematic for switching powwer regulator
    [reader.kicad_sch]
2026-01-07 Thinking about PCB layout
    [VLS6045EX-3R3N.stp, reader.kicad_pcb, reader.kicad_sch]
2026-01-07 Trying to fit everything
    [reader.kicad_pcb, reader.kicad_sch]
2026-01-20 Finished switching regulator layout
    [reader.kicad_pcb]
2026-04-02 Fixing datasheet link
    [heimdall_insideboard.kicad_sch]
2026-04-09 Transistor fixes
    [heimdall_insideboard.kicad_pcb, heimdall_insideboard.kicad_sch]
2026-04-12 Shift register OE
    [heimdall_insideboard.kicad_pcb, heimdall_insideboard.kicad_sch]
2026-04-12 SCK fix
    [heimdall_insideboard.kicad_pcb, heimdall_insideboard.kicad_sch]
2026-04-12 12V TVS, kinda
    [heimdall_insideboard.kicad_pcb, heimdall_insideboard.kicad_sch]
2026-04-14 TVS Diodes placed
    [heimdall_insideboard.kicad_pcb]
2026-04-14 Buzzer pin update
    [heimdall_insideboard.kicad_pcb, heimdall_insideboard.kicad_sch]
2026-04-14 Deleted some jumpers post validation
    [heimdall_insideboard.kicad_sch]
2026-04-14 Cleaning up jumper resistors
    [heimdall_insideboard.kicad_pcb, heimdall_insideboard.kicad_sch]
2026-04-15 New buzzer who dis
    [heimdall_insideboard.kicad_sch]
2026-04-16 LED swap
    [heimdall_insideboard.kicad_sch]
2026-04-17 Buzzer test PCB
    [buzzer_test.kicad_pcb, buzzer_test.kicad_sch]
